Orlanj/Iot-gg-medical-gas-monitor/docs/1792988379.png

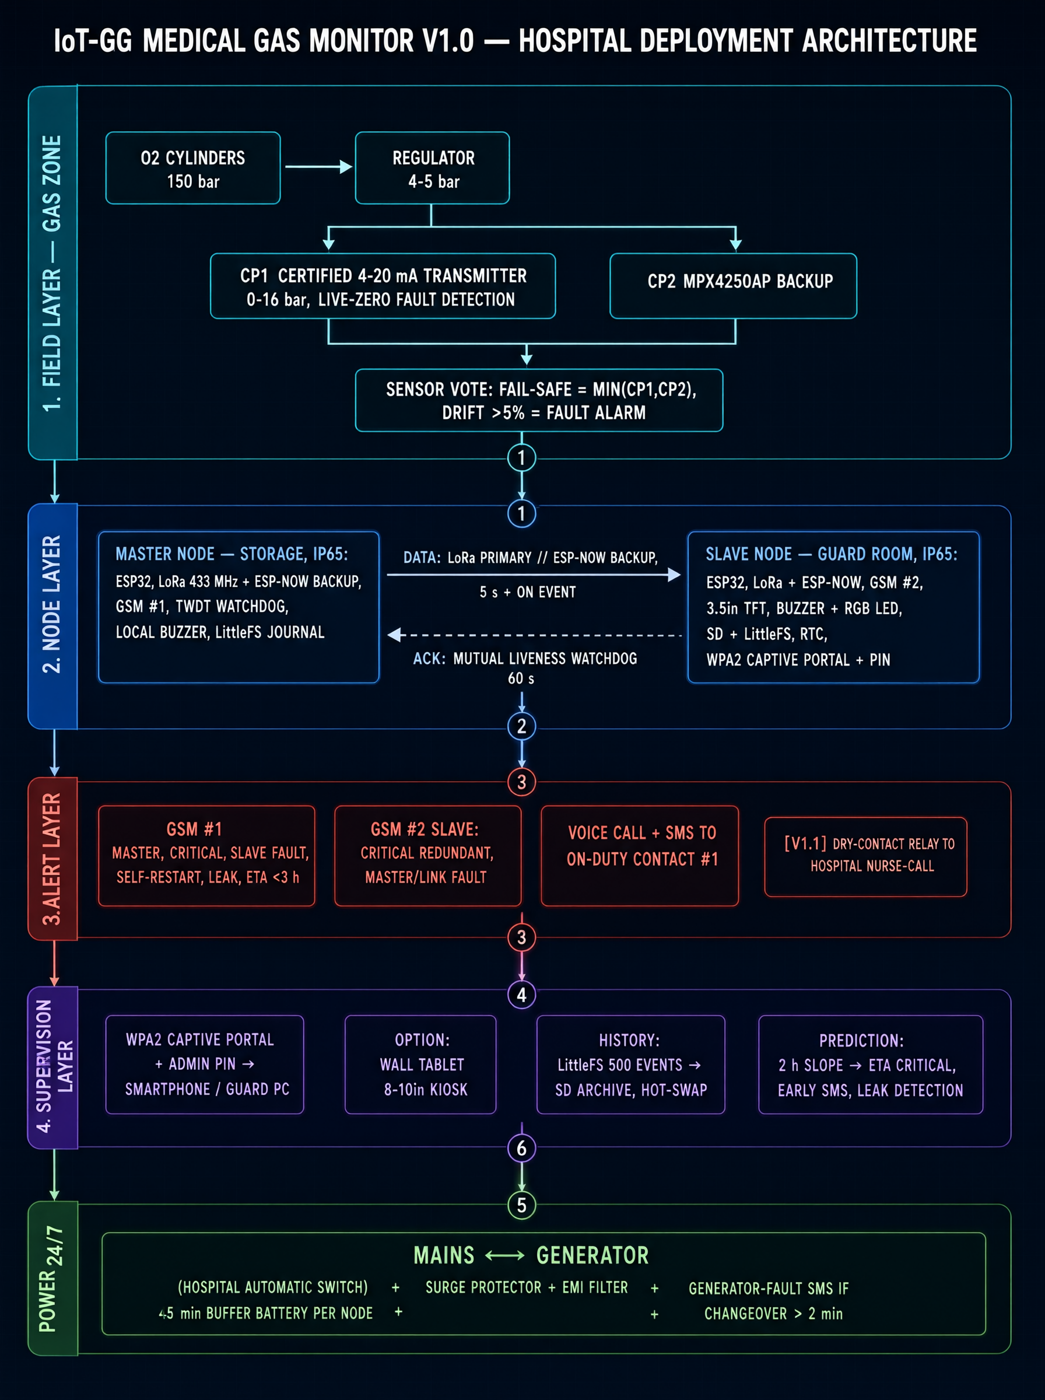
docs/1792988379.png
