Orlanj/Iot-gg-medical-gas-monitor/medias/pcb_FULL.png

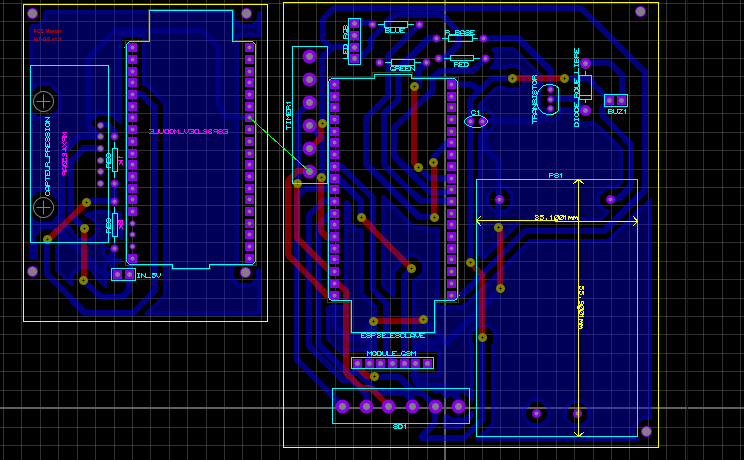
medias/pcb_FULL.png
