Orlanj/Iot-gg-medical-gas-monitor/medias/slave_1.png

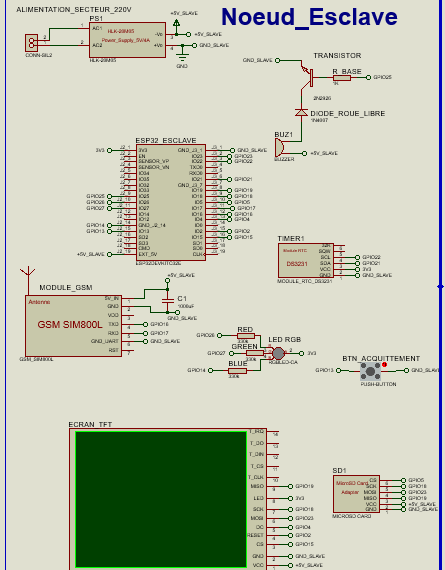
medias/slave_1.png
