Orlanj/Iot-gg-medical-gas-monitor/(commit log)

2026-10-26 docs: Ajout des dossiers docs, hardwares et medias
2026-10-26 Add files via upload
    printed circuit board of the entire device created using Proteus software
2026-11-06 Implement non-blocking pressure reading and alerts
    Added non-blocking pressure reading function and periodic alert mechanism for lost connection with slave device.
