Orlanj/Iot-gg-medical-gas-monitor/(notices)

Notices in the files:
README.md:
License: MIT
